jirayu3141/F9P_moving_base_pcb/ublox ZED-F9P (Full feature).kicad_pcb

## KiCad design ublox ZED-F9P (Full feature).kicad_pcb (2020-10-12)

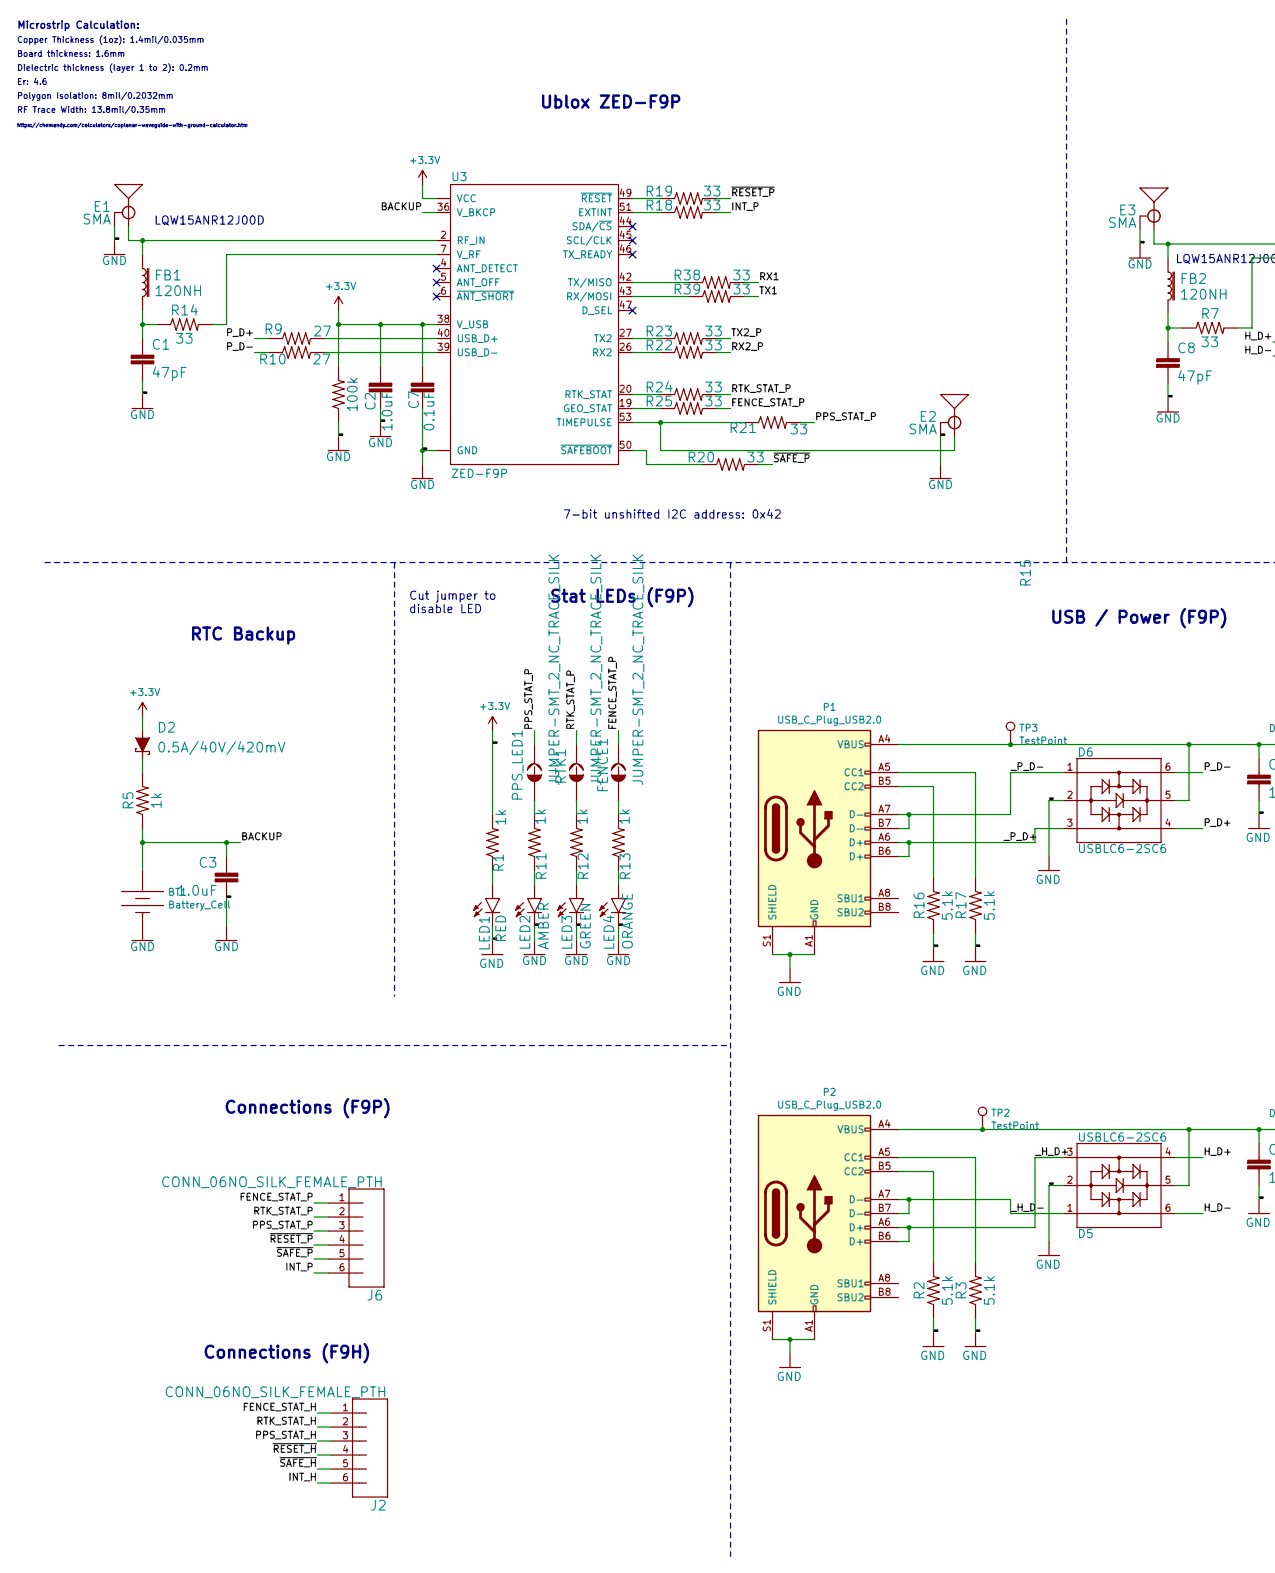
[picture p1: schematic ublox ZED-F9P (Full feature).sch, GNSS Module (Moving-Base RTK), part in row 1, column 1]

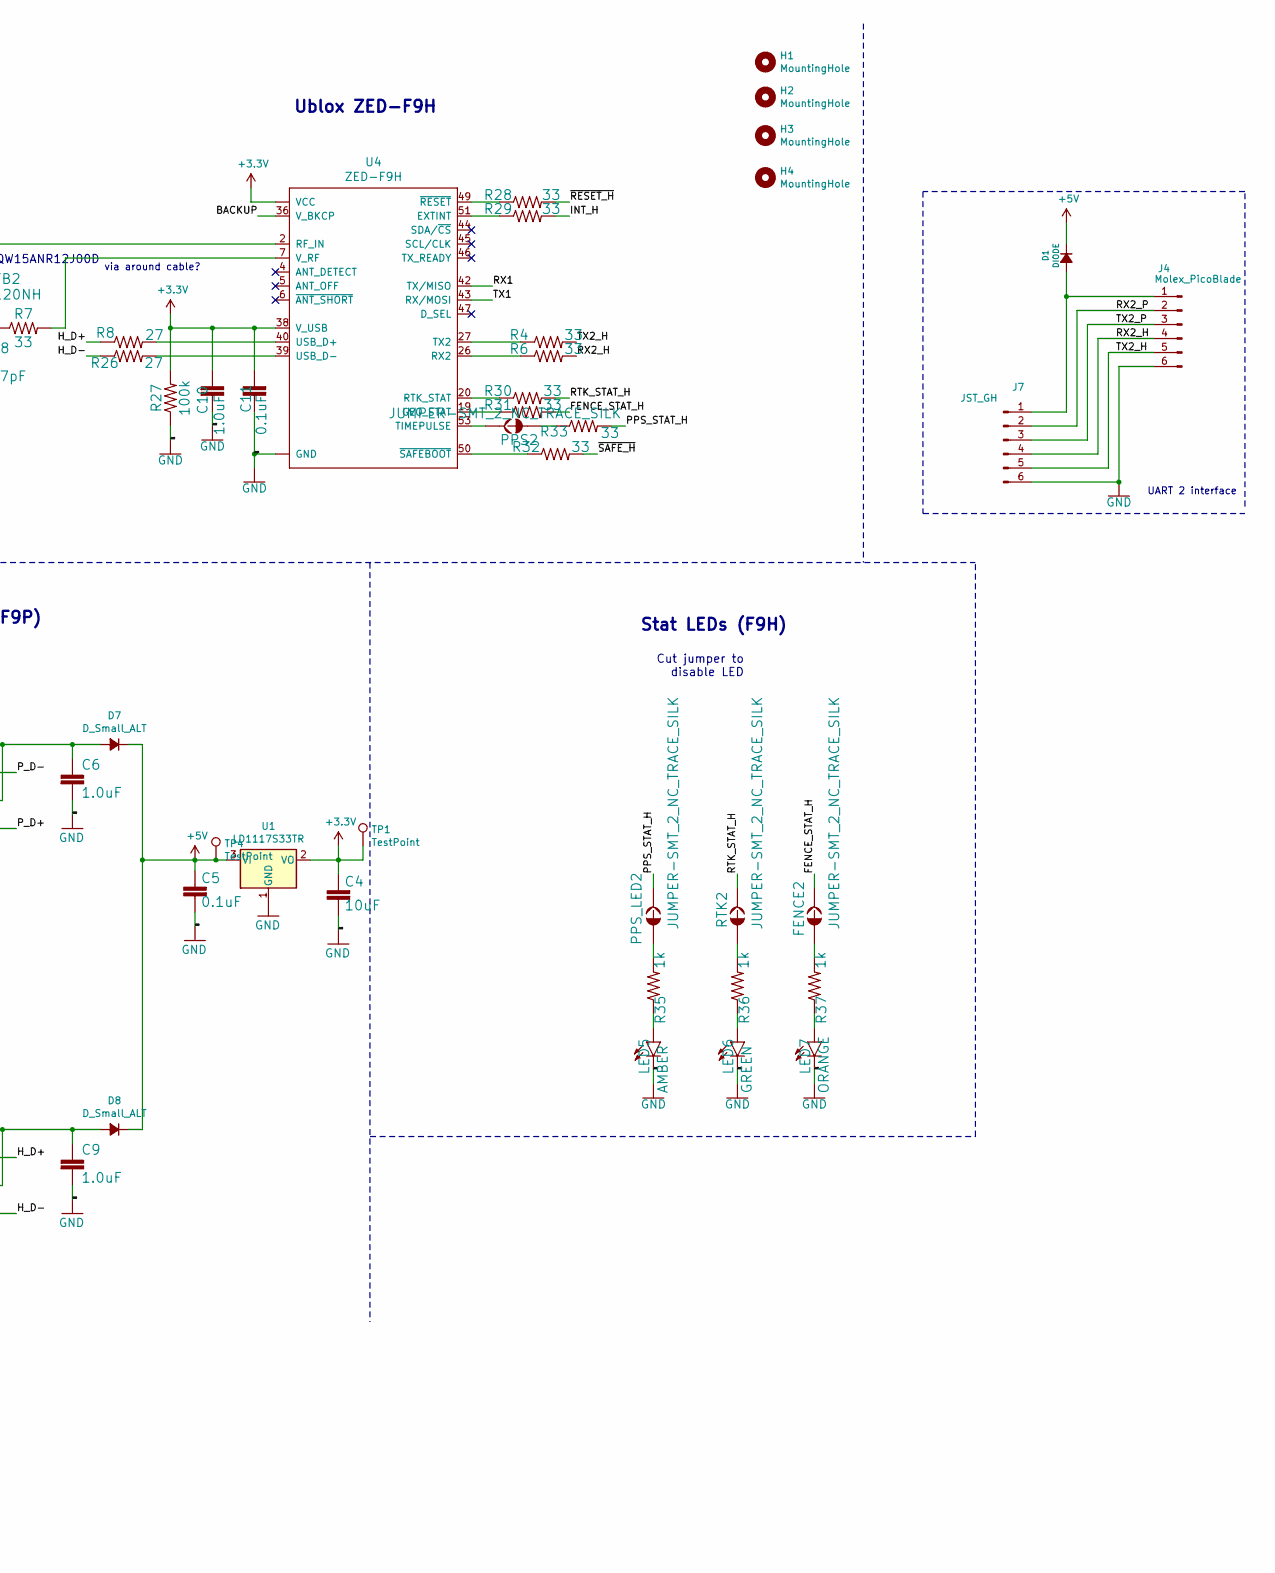
[picture p2: schematic ublox ZED-F9P (Full feature).sch, GNSS Module (Moving-Base RTK), part in row 1, column 2]

Parts:
BT1: Battery_Cell; ML414H_IV01E; partno ML414H IV01E
C1, C8: 47pF; 0402; partno 04023A470KAT2A
C2, C3, C6, C9, C10: 1.0uF; C_0603_1608Metric_Pad1.05x0.95mm_HandSolder; partno 0603YC105MAT2A
C4: 10uF; C_0603_1608Metric_Pad1.05x0.95mm_HandSolder; partno GRM188R61A106KE69D
C5, C7, C11: 0.1uF; C_0603_1608Metric_Pad1.05x0.95mm_HandSolder; partno MCCA000179
D1: DIODE; SOD-80; partno LS4150GS08
D2: 0.5A/40V/420mV; SOD-323; partno B0520WS-7-F
D5, D6: USBLC6-2SC6; SOT-23-6; partno USBLC6-2SC6
D7, D8: D_Small_ALT; SOD-80; partno LS4150GS08
E1, E2, E3: SMA; SMA-EDGE; partno CON-SMA-EDGE-S
FB1, FB2: 120NH; 0402_MURATA; partno BLM15AG100SN1D
FENCE1, FENCE2: JUMPER-SMT_2_NC_TRACE_SILK; SMT-JUMPER_2_NC_TRACE_SILK
H1, H2, H3, H4: MountingHole; MountingHole_3.2mm_M3
J2, J6: CONN_06NO_SILK_FEMALE_PTH; 1X06_NO_SILK
J4: Molex_PicoBlade; Molex_PicoBlade_53261-0671_1x06-1MP_P1.25mm_Horizontal; partno 532610671
J7: JST_GH; JST_GH_SM06B-GHS-TB_1x06-1MP_P1.25mm_Horizontal; partno SM06B-GHS-TB(LF)(SN)
LED1: RED; LED-0603; partno HSMH-C191
LED2, LED5: AMBER; LED-0603; partno HSMA-C191
LED3, LED6: GREEN; LED-0603; partno HSMG-C191
LED4, LED7: ORANGE; LED-0603; partno HSMD-C191
P1, P2: USB_C_Plug_USB2.0; USB_C_Receptacle_JAE_DX07S016JA1; partno DX07S016JA1R1500
PPS2: JUMPER-SMT_2_NC_TRACE_SILK; SMT-JUMPER_2_NC_TRACE_SILK
PPS_LED1, PPS_LED2: JUMPER-SMT_2_NC_TRACE_SILK; SMT-JUMPER_2_NC_TRACE_SILK
R1, R5, R11, R12, R13, R35, R36, R37: 1k; R_0603_1608Metric_Pad1.05x0.95mm_HandSolder; partno ERJ-3EKF1001V
R2, R3, R16, R17: 5.1k; R_0603_1608Metric_Pad1.05x0.95mm_HandSolder; partno ERJ-3EKF5101V
R4, R6, R7, R14, R18, R19, R20, R21, R22, R23, R24, R25, R28, R29, R30, R31, R32, R33, R38, R39: 33; R_0603_1608Metric_Pad1.05x0.95mm_HandSolder; partno ERJ-3EKF27R0V
R8, R9, R10, R26: 27; R_0603_1608Metric_Pad1.05x0.95mm_HandSolder; partno ERJ-3EKF27R0V
R15, R27: 100k; R_0603_1608Metric_Pad1.05x0.95mm_HandSolder; partno ERJ-3EKF1003V
RTK1, RTK2: JUMPER-SMT_2_NC_TRACE_SILK; SMT-JUMPER_2_NC_TRACE_SILK
TP1, TP2, TP3, TP4: TestPoint; TestPoint_Pad_D1.0mm
U1: LD1117S33TR; SOT-223; partno LD1117S33TR
U3: ZED-F9P; partno ZED-F9P-01B
U4: ZED-F9H; ZED-F9P

Connections:
+3V3: C2.1, C4.2, C7.2, C10.1, C11.2, D2.A, R1.2, R15.2, R27.2, TP1.1, U1.2 (VO), U3.33 (VCC), U3.34 (VCC), U3.38 (V_USB), U4.33 (VCC), U4.34 (VCC), U4.38 (V_USB); also elsewhere on the board
+5V: C5.2, D1.1 (K), D7.1 (K), D8.1 (K), TP4.1, U1.3 (VI); also elsewhere on the board
/BACKUP: BT1.+, C3.1, R5.1, U3.36 (V_BKCP), U4.36 (V_BKCP)
/FENCE_STAT_H: FENCE2.2, J2.1, R31.2
/FENCE_STAT_P: FENCE1.2, J6.1, R25.2
/H_D+: D5.4, R8.1
/H_D-: D5.6, R26.1
/INT_H: J2.6, R29.2
/INT_P: J6.6, R18.2
/PPS_STAT_H: J2.3, PPS_LED2.2, R33.2
/PPS_STAT_P: J6.3, PPS_LED1.2, R21.2
/P_D+: D6.4, R9.1
/P_D-: D6.6, R10.1
/RTK_STAT_H: J2.2, R30.2, RTK2.2
/RTK_STAT_P: J6.2, R24.2, RTK1.2
/RX1: R38.2, U4.42 (TX/MISO)
/RX2_H: J4.4, J7.4, R6.2
/RX2_P: J4.2, J7.2, R22.2
/TX1: R39.2, U4.43 (RX/MOSI)
/TX2_H: J4.5, J7.5, R4.2
/TX2_P: J4.3, J7.3, R23.2
/_H_D+: D5.3, P2.A6 (D+), P2.B6 (D+)
/_H_D-: D5.1, P2.A7 (D-), P2.B7 (D-)
/_P_D+: D6.3, P1.A6 (D+), P1.B6 (D+)
/_P_D-: D6.1, P1.A7 (D-), P1.B7 (D-)
/~RESET_H: J2.4, R28.2
/~RESET_P: J6.4, R19.2
/~SAFE_H: J2.5, R32.2
/~SAFE_P: J6.5, R20.2
GND: BT1.-, C1.2, C2.2, C3.2, C4.1, C5.1, C6.2, C7.1, C8.2, C9.2, C10.2, C11.1, D5.2, D6.2, E1.GND@0 (GND), E1.GND@1 (GND), E1.GND@2 (GND), E1.GND@3 (GND), E2.GND@0 (GND), E2.GND@1 (GND), E2.GND@2 (GND), E2.GND@3 (GND), E3.GND@0 (GND), E3.GND@1 (GND), E3.GND@2 (GND), E3.GND@3 (GND), J4.6, J7.6, LED1.C, LED2.C, LED3.C, LED4.C, LED5.C, LED6.C, LED7.C, P1.A1 (GND), P1.A12 (GND), P1.B1 (GND), P1.B12 (GND), P1.S1 (SHIELD), P2.A1 (GND), P2.A12 (GND), P2.B1 (GND), P2.B12 (GND), P2.S1 (SHIELD), R2.1, R3.1, R15.1, R16.1, R17.1, R27.1, U1.1 (GND), U3.1 (GND), U3.3 (GND), U3.12 (GND), U3.14 (GND), U3.32 (GND), U3.37 (GND), U3.41 (GND), U3.48 (GND), U3.55 (GND), U3.56 (GND), U3.57 (GND), U3.58 (GND), U3.59 (GND), U3.60 (GND), U3.61 (GND), U3.62 (GND), U3.63 (GND), U3.64 (GND), U3.65 (GND), U3.66 (GND), U3.67 (GND), U3.68 (GND), U3.69 (GND), U3.70 (GND), U3.71 (GND), U3.72 (GND), U3.73 (GND), U3.74 (GND), U3.75 (GND), U3.76 (GND), U3.77 (GND), U3.78 (GND), U3.79 (GND), U3.80 (GND), U3.81 (GND), U3.82 (GND), U3.83 (GND), U3.84 (GND), U3.85 (GND), U3.86 (GND), U3.87 (GND), U3.88 (GND), U3.89 (GND), U3.90 (GND), U3.91 (GND), U3.92 (GND), U3.93 (GND), U3.94 (GND), U3.95 (GND), U3.96 (GND), U3.97 (GND), U3.98 (GND), U3.99 (GND), U3.100 (GND), U3.101 (GND), U3.102 (GND), U4.1 (GND), U4.3 (GND), U4.12 (GND), U4.14 (GND), U4.32 (GND), U4.37 (GND), U4.41 (GND), U4.48 (GND), U4.55 (GND), U4.56 (GND), U4.57 (GND), U4.58 (GND), U4.59 (GND), U4.60 (GND), U4.61 (GND), U4.62 (GND), U4.63 (GND), U4.64 (GND), U4.65 (GND), U4.66 (GND), U4.67 (GND), U4.68 (GND), U4.69 (GND), U4.70 (GND), U4.71 (GND), U4.72 (GND), U4.73 (GND), U4.74 (GND), U4.75 (GND), U4.76 (GND), U4.77 (GND), U4.78 (GND), U4.79 (GND), U4.80 (GND), U4.81 (GND), U4.82 (GND), U4.83 (GND), U4.84 (GND), U4.85 (GND), U4.86 (GND), U4.87 (GND), U4.88 (GND), U4.89 (GND), U4.90 (GND), U4.91 (GND), U4.92 (GND), U4.93 (GND), U4.94 (GND), U4.95 (GND), U4.96 (GND), U4.97 (GND), U4.98 (GND), U4.99 (GND), U4.100 (GND), U4.101 (GND), U4.102 (GND)
unnamed: C1.1, FB1.P2 (2), R14.1
unnamed 31: C6.1, D6.5, D7.2 (A), P1.A4 (VBUS), P1.A9 (VBUS), P1.B4 (VBUS), P1.B9 (VBUS), TP3.1; also elsewhere on the board
unnamed: C8.1, FB2.P2 (2), R7.1
unnamed 33: C9.1, D5.5, D8.2 (A), P2.A4 (VBUS), P2.A9 (VBUS), P2.B4 (VBUS), P2.B9 (VBUS), TP2.1; also elsewhere on the board
unnamed: D1.2 (A), J4.1, J7.1
unnamed: D2.C, R5.2
unnamed: E1.SIG (SIGNAL), FB1.P1 (1), U3.2 (RF_IN)
unnamed: E2.SIG (SIGNAL), R21.1, U3.53 (TIMEPULSE)
unnamed: E3.SIG (SIGNAL), FB2.P1 (1), U4.2 (RF_IN)
unnamed: FENCE1.1, R13.2
unnamed: FENCE2.1, R37.2
unnamed: LED1.A, R1.1
unnamed: LED2.A, R11.1
unnamed: LED3.A, R12.1
unnamed: LED4.A, R13.1
unnamed: LED5.A, R35.1
unnamed: LED6.A, R36.1
unnamed: LED7.A, R37.1
unnamed: P1.A5 (CC1), R17.2
unnamed: P1.B5 (CC2), R16.2
unnamed: P2.A5 (CC1), R3.2
unnamed: P2.B5 (CC2), R2.2
unnamed: PPS2.1, R33.1
unnamed: PPS2.2, U4.53 (TIMEPULSE)
unnamed: PPS_LED1.1, R11.2
unnamed: PPS_LED2.1, R35.2
unnamed: R4.1, U4.27 (TX2)
unnamed: R6.1, U4.26 (RX2)
unnamed: R7.2, U4.7 (V_RF)
unnamed: R8.2, U4.40 (USB_D+)
unnamed: R9.2, U3.40 (USB_D+)
unnamed: R10.2, U3.39 (USB_D-)
unnamed: R12.2, RTK1.1
unnamed: R14.2, U3.7 (V_RF)
unnamed: R18.1, U3.51 (EXTINT)
unnamed: R19.1, U3.49 (~RESET~)
unnamed: R20.1, U3.50 (~SAFEBOOT~)
unnamed: R22.1, U3.26 (RX2)
unnamed: R23.1, U3.27 (TX2)
unnamed: R24.1, U3.20 (RTK_STAT)
unnamed: R25.1, U3.19 (GEO_STAT)
unnamed: R26.2, U4.39 (USB_D-)
unnamed: R28.1, U4.49 (~RESET~)
unnamed: R29.1, U4.51 (EXTINT)
unnamed: R30.1, U4.20 (RTK_STAT)
unnamed: R31.1, U4.19 (GEO_STAT)
unnamed: R32.1, U4.50 (~SAFEBOOT~)
unnamed: R36.2, RTK2.1
unnamed: R38.1, U3.42 (TX/MISO)
unnamed: R39.1, U3.43 (RX/MOSI)

Notes on the sheet:
7-bit unshifted I2C address: 0x42
Ublox ZED-F9P
RTC Backup
Cut jumper to disable LED
LQW15ANR12J00D
Board thickness: 1.6mm
Er: 4.6
Copper Thickness (1oz): 1.4mil/0.035mm
RF Trace Width: 13.8mil/0.35mm
Polygon Isolation: 8mil/0.2032mm
Dielectric thickness (layer 1 to 2): 0.2mm
https://chemandy.com/calculators/coplanar-waveguide-with-ground-calculator.htm
Microstrip Calculation:
Connections (F9P)
USB / Power (F9P)
Ublox ZED-F9H
Stat LEDs (F9P)
Stat LEDs (F9H)
Connections (F9H)
via around cable?
UART 2 interface

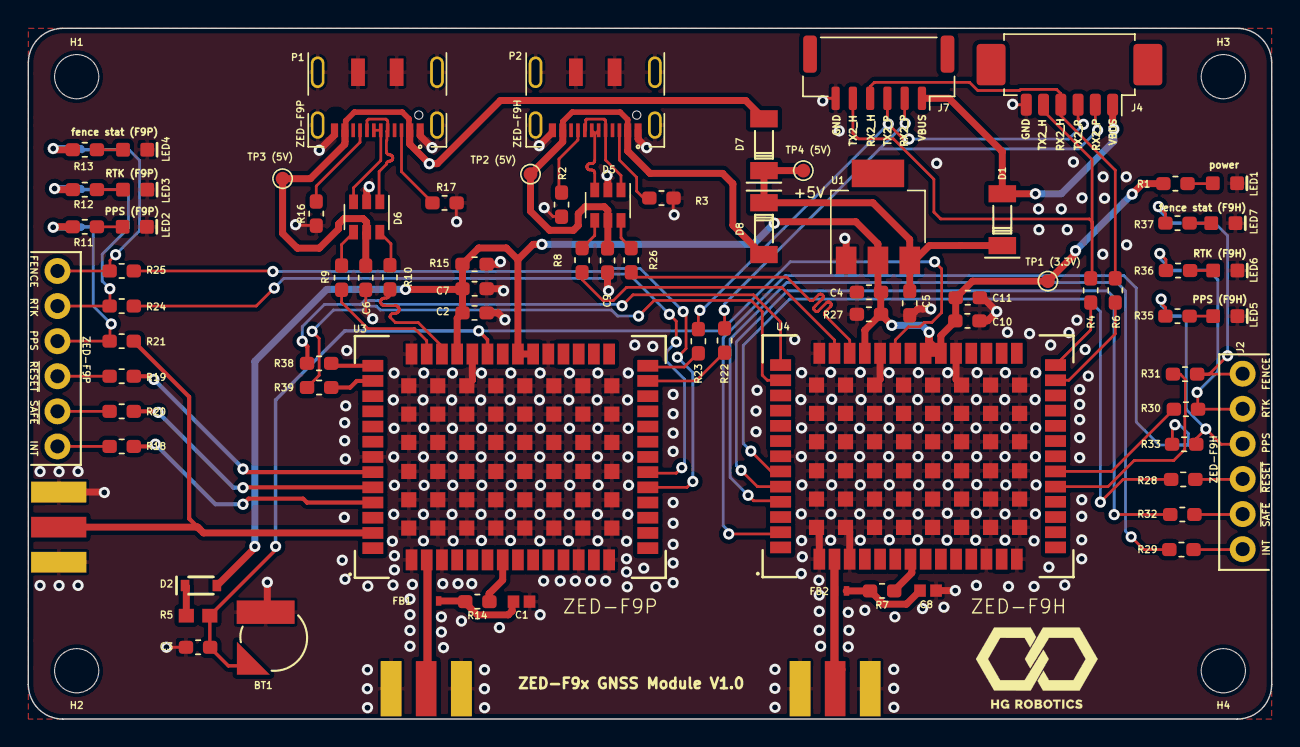
[picture p3: board ublox ZED-F9P (Full feature).kicad_pcb from above]

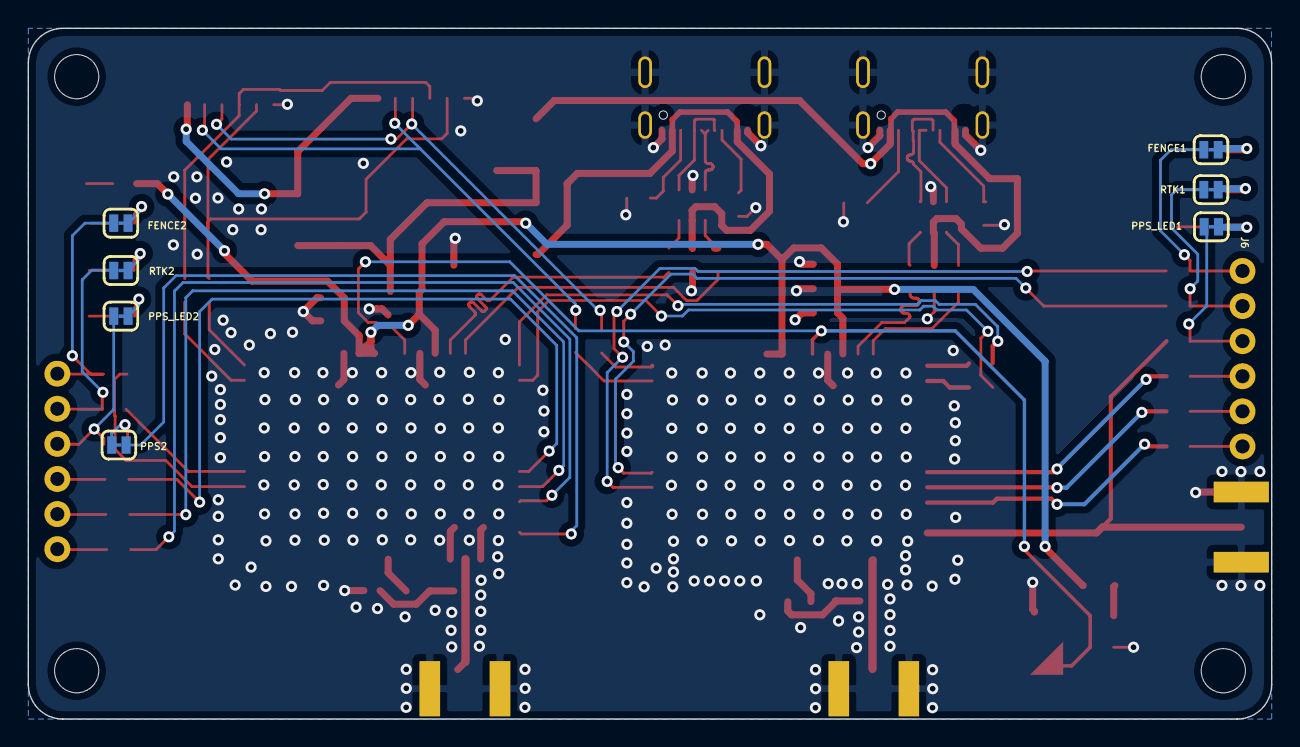
[picture p4: board ublox ZED-F9P (Full feature).kicad_pcb from below]

Board: 4 copper layers, 90.0 x 50.0 mm, 92 parts (8 on the bottom side), 80 nets.

Other parts of the board:
TP1 (3.3V), TP2 (5V), TP3 (5V), TP4 (5V): TestPoint; TestPoint_Pad_D1.0mm

Their connections:
+3V3: TP1 (3.3V).1; also elsewhere on the board
+5V: TP4 (5V).1; also elsewhere on the board
unnamed 31: TP3 (5V).1; also elsewhere on the board
unnamed 33: TP2 (5V).1; also elsewhere on the board
