jirayu3141/F9P_moving_base_pcb/F9R.kicad_pcb

## KiCad design F9R.kicad_pcb (2020-10-07)

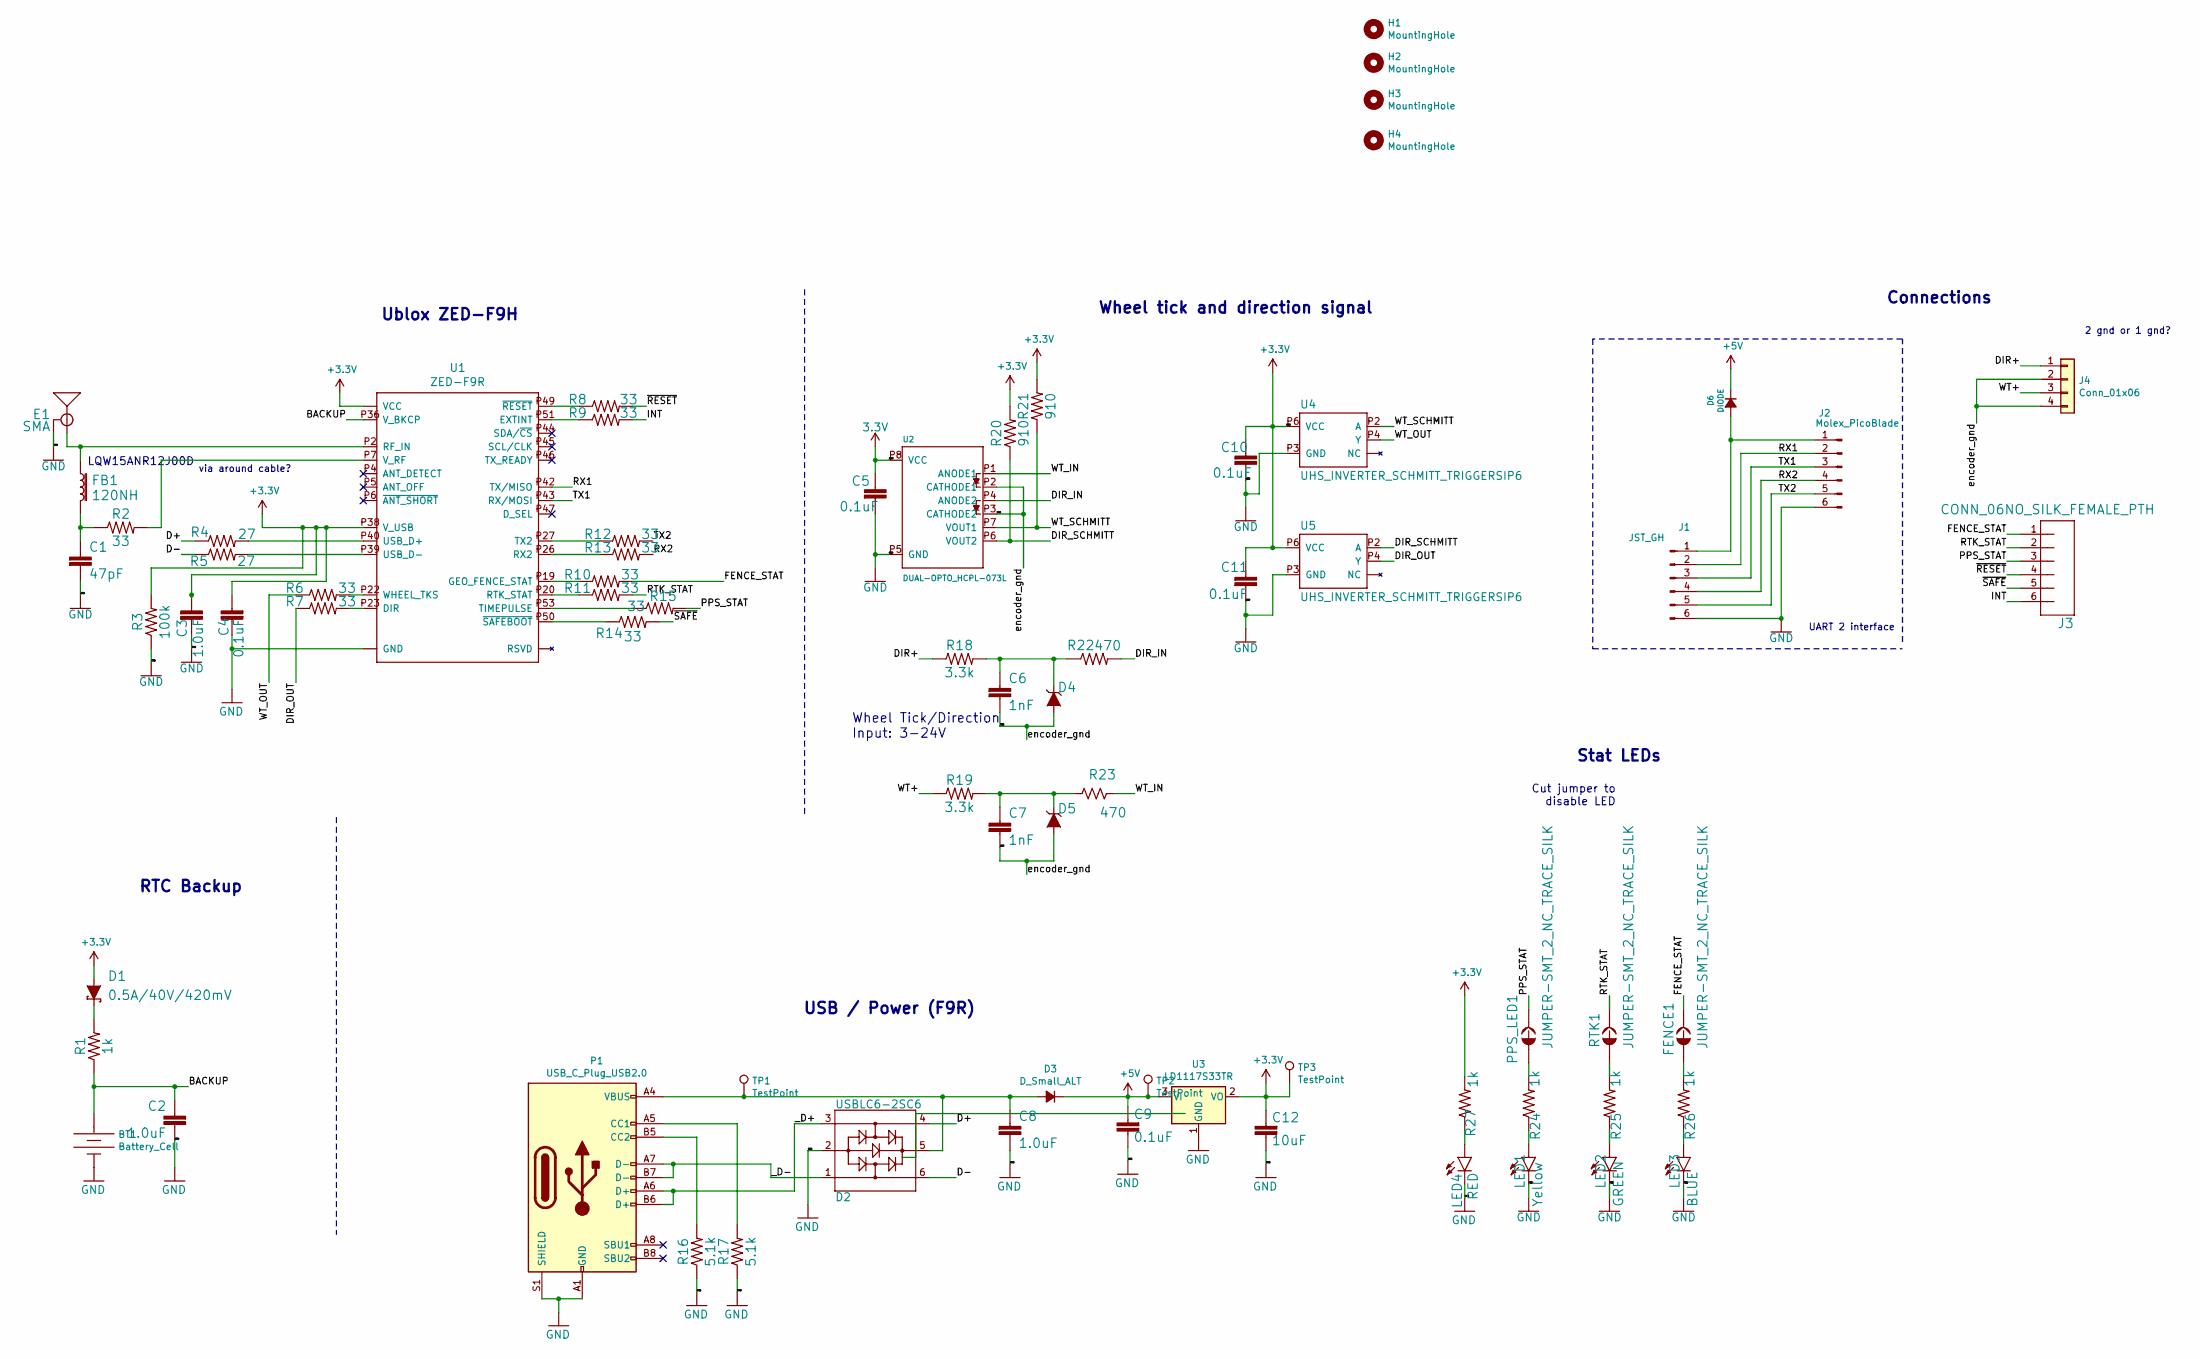
[picture p5: schematic F9R.sch, GNSS Module (Moving-Base RTK) ZED F9R]

Parts:
BT1: Battery_Cell; ML414H_IV01E; partno ML414H IV01E
C1: 47pF; 0402; partno 04023A470KAT2A
C2, C3, C8: 1.0uF; C_0603_1608Metric_Pad1.05x0.95mm_HandSolder; partno 0603YC105KAT2A
C4, C9: 0.1uF; C_0603_1608Metric_Pad1.05x0.95mm_HandSolder; partno 0603YC104KAT2A
C5, C10, C11: 0.1uF; C_0603_1608Metric_Pad1.05x0.95mm_HandSolder
C6, C7: 1nF; C_0603_1608Metric_Pad1.05x0.95mm_HandSolder
C12: 10uF; C_0603_1608Metric_Pad1.05x0.95mm_HandSolder; partno 0603ZD106KAT2A
D1: 0.5A/40V/420mV; SOD-323; partno B0520WS-7-F
D2: USBLC6-2SC6; SOT-23-6; partno USBLC6-2SC6
D3: D_Small_ALT; SOD-80; partno LS4150GS08
D4, D5: 15V; SOT23-3
D6: DIODE; SOD-80; partno LS4150GS08
E1: SMA; SMA-EDGE; partno CON-SMA-EDGE-S
FB1: 120NH; 0402_MURATA; partno BLM15AG100SN1D
FENCE1: JUMPER-SMT_2_NC_TRACE_SILK; SMT-JUMPER_2_NC_TRACE_SILK
H1, H2, H3, H4: MountingHole; MountingHole_3.2mm_M3
J1: JST_GH; JST_GH_SM06B-GHS-TB_1x06-1MP_P1.25mm_Horizontal; partno SM06B-GHS-TB(LF)(SN)
J2: Molex_PicoBlade; Molex_PicoBlade_53261-0671_1x06-1MP_P1.25mm_Horizontal; partno 0532610671
J3: CONN_06NO_SILK_FEMALE_PTH; 1X06_NO_SILK
J4: Conn_01x06; Molex_CLIK-Mate_502443-0470_1x04-1MP_P2.00mm_Vertical
LED1: Yellow; LED-0603; partno LY Q396-P1Q2-36
LED2: GREEN; LED-0603; partno HSMG-C120
LED3: BLUE; LED-0603; partno 150060BS55040
LED4: RED; LED-0603; partno HSMH-C191
P1: USB_C_Plug_USB2.0; USB_C_Receptacle_JAE_DX07S016JA1
PPS_LED1: JUMPER-SMT_2_NC_TRACE_SILK; SMT-JUMPER_2_NC_TRACE_SILK
R1: 1k; 0603; partno ERJ-3EKF1001V
R2, R6, R7, R8, R9, R10, R11, R12, R13, R14, R15: 33; R_0603_1608Metric_Pad1.05x0.95mm_HandSolder; partno ERJ-3EKF27R0V
R3: 100k; R_0603_1608Metric_Pad1.05x0.95mm_HandSolder; partno ERJ-3EKF1003V
R4, R5: 27; R_0603_1608Metric_Pad1.05x0.95mm_HandSolder; partno ERJ-3EKF27R0V
R16, R17: 5.1k; R_0603_1608Metric_Pad1.05x0.95mm_HandSolder; partno ERJ-3EKF5101V
R18, R19: 3.3k; R_0603_1608Metric_Pad1.05x0.95mm_HandSolder
R20, R21: 910; R_0603_1608Metric_Pad1.05x0.95mm_HandSolder
R22, R23: 470; R_0603_1608Metric_Pad1.05x0.95mm_HandSolder
R24, R25, R26, R27: 1k; R_0603_1608Metric_Pad1.05x0.95mm_HandSolder; partno ERJ-3EKF1001V
RTK1: JUMPER-SMT_2_NC_TRACE_SILK; SMT-JUMPER_2_NC_TRACE_SILK
TP1, TP2, TP3: TestPoint; TestPoint_Pad_D1.0mm
U1: ZED-F9R; UBLOX_ZED_F9R
U2: DUAL-OPTO_HCPL-073L; SOP_8-PIN
U3: LD1117S33TR; SOT-223; partno LD1117S33TR
U4, U5: UHS_INVERTER_SCHMITT_TRIGGERSIP6; SIP6

Connections:
+3V3: C3.1, C4.2, C5.1, C10.1, C11.1, C12.2, D1.A, R3.2, R20.2, R21.2, R27.2, TP3.1, U1.P33 (VCC), U1.P34 (VCC), U1.P38 (V_USB), U2.P8 (VCC), U3.2 (VO), U4.P6 (VCC), U5.P6 (VCC)
+5V: C9.2, D3.1 (K), D6.1 (K), TP2.1, U3.3 (VI)
/BACKUP: BT1.+, C2.1, R1.1, U1.P36 (V_BKCP)
/D+: D2.4, R4.1
/D-: D2.6, R5.1
/DIR+: J4.1, R18.1
/DIR_IN: R22.2, U2.P4 (ANODE2)
/DIR_OUT: R7.1, U5.P4 (Y)
/DIR_SCHMITT: R20.1, U2.P6 (VOUT2), U5.P2 (A)
/FENCE_STAT: FENCE1.2, J3.1, R10.2
/INT: J3.6, R9.2
/PPS_STAT: J3.3, PPS_LED1.2, R15.2
/RTK_STAT: J3.2, R11.2, RTK1.2
/RX1: J1.2, J2.2, U1.P42 (TX/MISO)
/RX2: J1.4, J2.4, R13.2
/TX1: J1.3, J2.3, U1.P43 (RX/MOSI)
/TX2: J1.5, J2.5, R12.2
/WT+: J4.3, R19.1
/WT_IN: R23.1, U2.P1 (ANODE1)
/WT_OUT: R6.1, U4.P4 (Y)
/WT_SCHMITT: R21.1, U2.P7 (VOUT1), U4.P2 (A)
/_D+: D2.3, P1.A6 (D+), P1.B6 (D+)
/_D-: D2.1, P1.A7 (D-), P1.B7 (D-)
/~RESET: J3.4, R8.2
/~SAFE: J3.5, R14.2
GND: BT1.-, C1.2, C2.2, C3.2, C4.1, C5.2, C6.2, C7.2, C8.2, C9.1, C10.2, C11.2, C12.1, D2.2, D4.1 (A), D5.1 (A), E1.GND@0 (GND), E1.GND@1 (GND), E1.GND@2 (GND), E1.GND@3 (GND), J1.6, J2.6, J4.2, J4.4, LED1.C, LED2.C, LED3.C, LED4.C, P1.A1 (GND), P1.A12 (GND), P1.B1 (GND), P1.B12 (GND), P1.S1 (SHIELD), R3.1, R16.1, R17.1, U1.G1 (GND), U1.G2 (GND), U1.G3 (GND), U1.G4 (GND), U1.G5 (GND), U1.G6 (GND), U1.G7 (GND), U1.G8 (GND), U1.G9 (GND), U1.G10 (GND), U1.G11 (GND), U1.G12 (GND), U1.G13 (GND), U1.G14 (GND), U1.G15 (GND), U1.G16 (GND), U1.G17 (GND), U1.G18 (GND), U1.G19 (GND), U1.G20 (GND), U1.G21 (GND), U1.G22 (GND), U1.G23 (GND), U1.G24 (GND), U1.G25 (GND), U1.G26 (GND), U1.G27 (GND), U1.G28 (GND), U1.G29 (GND), U1.G30 (GND), U1.G31 (GND), U1.G32 (GND), U1.G33 (GND), U1.G34 (GND), U1.G35 (GND), U1.G36 (GND), U1.G37 (GND), U1.G38 (GND), U1.G39 (GND), U1.G40 (GND), U1.G41 (GND), U1.G42 (GND), U1.G43 (GND), U1.G44 (GND), U1.G45 (GND), U1.G46 (GND), U1.G47 (GND), U1.G48 (GND), U1.P1 (GND), U1.P3 (GND), U1.P12 (GND), U1.P14 (GND), U1.P32 (GND), U1.P37 (GND), U1.P41 (GND), U1.P48 (GND), U2.P2 (CATHODE1), U2.P3 (CATHODE2), U2.P5 (GND), U3.1 (GND), U4.P3 (GND), U5.P3 (GND)
unnamed: C1.1, FB1.P2 (2), R2.1
unnamed: C6.1, D4.3 (C), R18.2, R22.1
unnamed: C7.1, D5.3 (C), R19.2, R23.2
unnamed: C8.1, D2.5, D3.2 (A), P1.A4 (VBUS), P1.A9 (VBUS), P1.B4 (VBUS), P1.B9 (VBUS), TP1.1
unnamed: D1.C, R1.2
unnamed: D6.2 (A), J1.1, J2.1
unnamed: E1.SIG (SIGNAL), FB1.P1 (1), U1.P2 (RF_IN)
unnamed: FENCE1.1, R26.2
unnamed: LED1.A, R24.1
unnamed: LED2.A, R25.1
unnamed: LED3.A, R26.1
unnamed: LED4.A, R27.1
unnamed: P1.A5 (CC1), R17.2
unnamed: P1.B5 (CC2), R16.2
unnamed: PPS_LED1.1, R24.2
unnamed: R2.2, U1.P7 (V_RF)
unnamed: R4.2, U1.P40 (USB_D+)
unnamed: R5.2, U1.P39 (USB_D-)
unnamed: R6.2, U1.P22 (WHEEL_TKS)
unnamed: R7.2, U1.P23 (DIR)
unnamed: R8.1, U1.P49 (~RESET~)
unnamed: R9.1, U1.P51 (EXTINT)
unnamed: R10.1, U1.P19 (GEO_FENCE_STAT)
unnamed: R11.1, U1.P20 (RTK_STAT)
unnamed: R12.1, U1.P27 (TX2)
unnamed: R13.1, U1.P26 (RX2)
unnamed: R14.1, U1.P50 (~SAFEBOOT~)
unnamed: R15.1, U1.P53 (TIMEPULSE)
unnamed: R25.2, RTK1.1

Notes on the sheet:
RTC Backup
USB / Power (F9R)
Ublox ZED-F9H
Cut jumper to disable LED
LQW15ANR12J00D
Stat LEDs
via around cable?
UART 2 interface
Wheel Tick/Direction Input: 3-24V
Wheel tick and direction signal
2 gnd or 1 gnd?
Connections

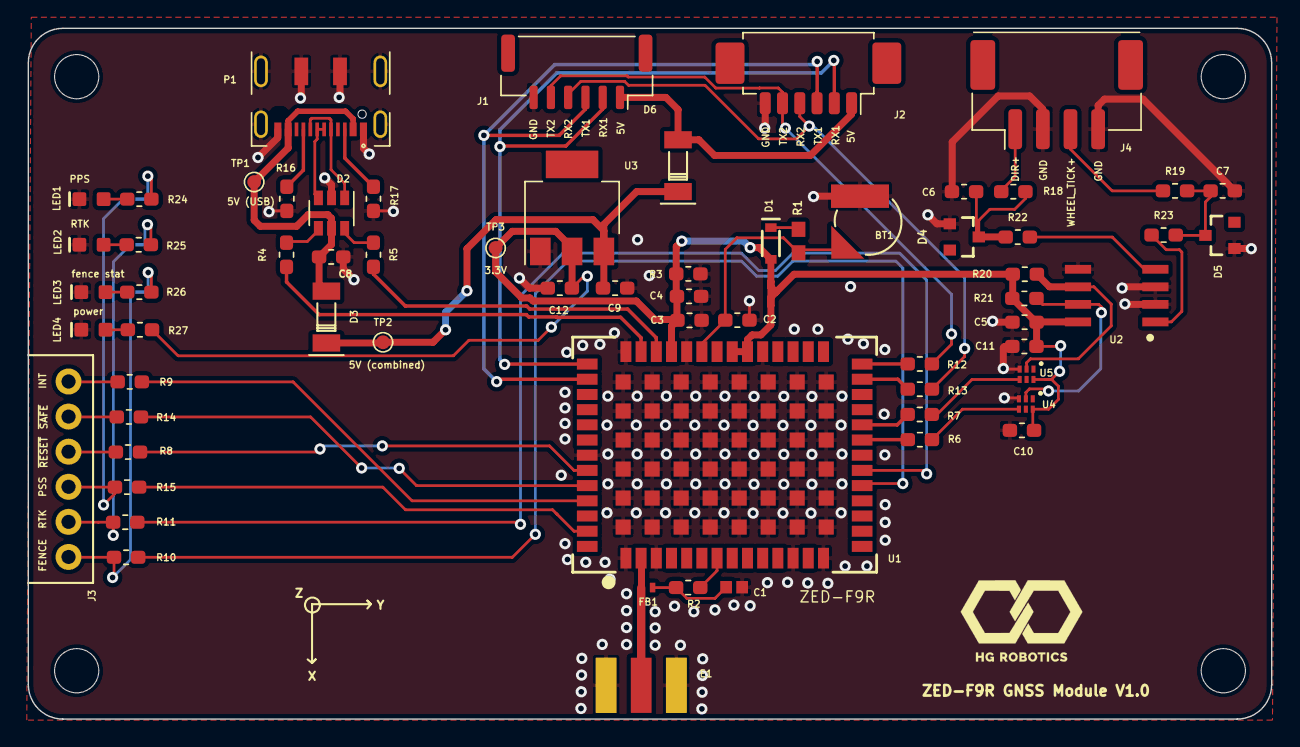
[picture p6: board F9R.kicad_pcb from above]

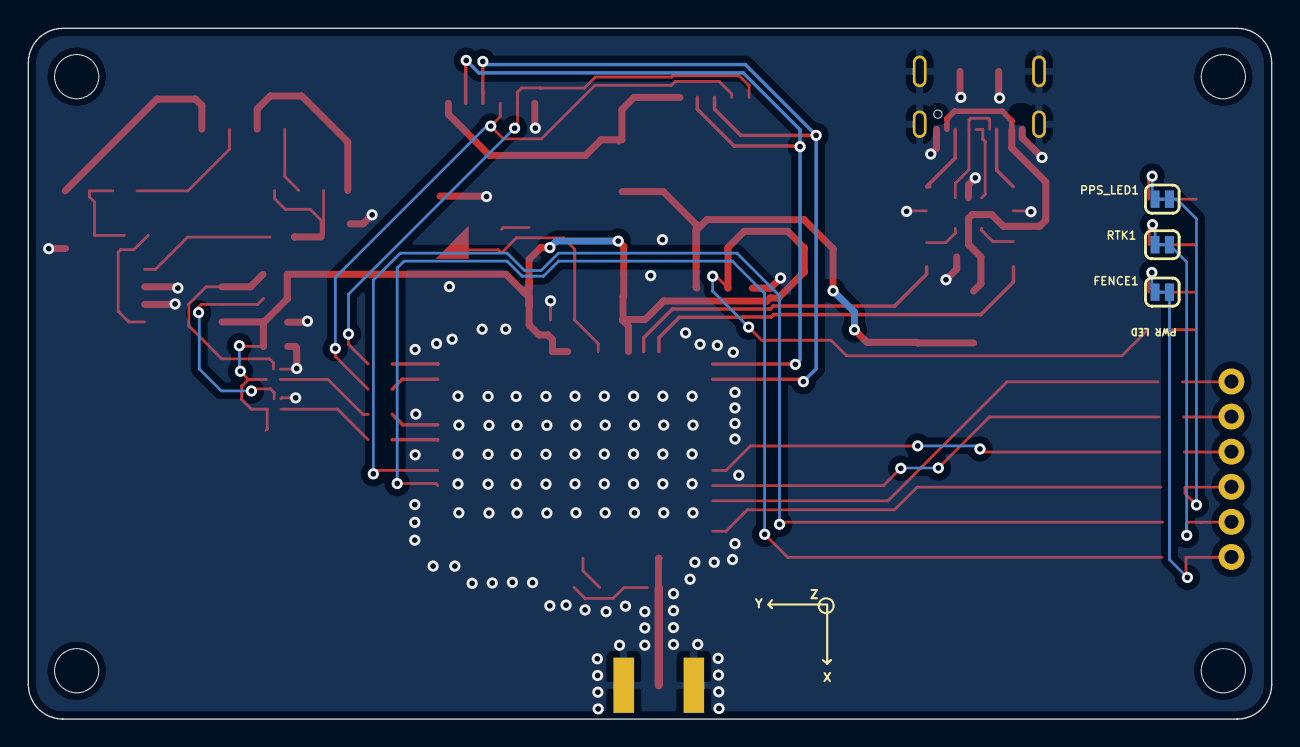
[picture p7: board F9R.kicad_pcb from below]

Board: 4 copper layers, 90.0 x 50.0 mm, 72 parts (3 on the bottom side), 55 nets.
