jirayu3141/F9P_moving_base_pcb/(commit log)

2020-09-23 name changed
    [ublox ZED-F9P (Full feature).kicad_pcb, ublox ZED-F9P (Full feature).sch]
2020-09-23 Try pushing this repo
    [ublox ZED-F9P (Full feature).sch]
2020-09-23 Update partno
    [ublox ZED-F9P (Full feature).sch]
2020-09-23 part no updated
    [ublox ZED-F9P (Full feature).sch]
2020-09-24 removed unescessary resistors
    [ublox ZED-F9P (Full feature).sch]
2020-09-24 removed SMA time paulse from F9H
    [ublox ZED-F9P (Full feature).sch]
2020-09-26 changed usb c
    [ublox ZED-F9P (Full feature).kicad_pcb, ublox ZED-F9P (Full feature).sch]
2020-09-29 changed usb c differential pair
    [ublox ZED-F9P (Full feature).kicad_pcb, ublox ZED-F9P (Full feature).sch]
2020-10-01 finished routing
    [ublox ZED-F9P (Full feature) copy.kicad_pcb, ublox ZED-F9P (Full feature).sch]
2020-10-01 updated new consistent footprint and silkscreen
    [ublox ZED-F9P (Full feature).kicad_pcb, ublox ZED-F9P (Full feature).sch]
2020-10-01 updated silkscreen
    [ublox ZED-F9P (Full feature).kicad_pcb]
2020-10-01 added logo;
    [ublox ZED-F9P (Full feature).kicad_pcb]
2020-10-01 finished export
    [ublox ZED-F9P (Full feature)-B_Cu.gbr, ublox ZED-F9P (Full feature)-B_Mask.gbr, ublox ZED-F9P (Full feature)-B_Paste.gbr, ublox ZED-F9P (Full feature)-B_SilkS.gbr, ublox ZED-F9P (Full feature)-Edge_Cuts.gbr, ublox ZED-F9P (Full feature)-F_Cu.gbr, ublox ZED-F9P (Full feature)-F_Mask.gbr, ublox ZED-F9P (Full feature)-F_Paste.gbr]
2020-10-02 finished v1.1
    [ublox ZED-F9P (Full feature)-B_Cu.gbr, ublox ZED-F9P (Full feature)-B_Mask.gbr, ublox ZED-F9P (Full feature)-B_Paste.gbr, ublox ZED-F9P (Full feature)-B_SilkS.gbr, ublox ZED-F9P (Full feature)-Edge_Cuts.gbr, ublox ZED-F9P (Full feature)-F_Cu.gbr, ublox ZED-F9P (Full feature)-F_Mask.gbr, ublox ZED-F9P (Full feature)-F_Paste.gbr]
2020-10-02 genereated output
    [ublox ZED-F9P (Full feature)-B_Cu.gbr, ublox ZED-F9P (Full feature)-B_Mask.gbr, ublox ZED-F9P (Full feature)-B_Paste.gbr, ublox ZED-F9P (Full feature)-B_SilkS.gbr, ublox ZED-F9P (Full feature)-Edge_Cuts.gbr, ublox ZED-F9P (Full feature)-F_Cu.gbr, ublox ZED-F9P (Full feature)-F_Mask.gbr, ublox ZED-F9P (Full feature)-F_Paste.gbr]
2020-10-02 deleted unused files
    [ublox ZED-F9P (Full feature).kicad_pcb]
2020-10-06 routed f9r
    [F9R.kicad_pcb, F9R.sch, file5F77EE76.sch]
2020-10-06 rearrange silkscreen H1-H4,P1-P2,J4,J7 remove bottom silkscreen PWR LED resize all footprint references to height0.5,width0.5,thichness0.1 mm Add silkscreen label for pins of J2,J4,J6, J7
    [ublox ZED-F9P (Full feature)-B_Cu.gbr, ublox ZED-F9P (Full feature)-B_Mask.gbr, ublox ZED-F9P (Full feature)-B_Paste.gbr, ublox ZED-F9P (Full feature)-B_SilkS.gbr, ublox ZED-F9P (Full feature)-Edge_Cuts.gbr, ublox ZED-F9P (Full feature)-F_Cu.gbr, ublox ZED-F9P (Full feature)-F_Mask.gbr, ublox ZED-F9P (Full feature)-F_Paste.gbr]
2020-10-06 finished f9r
    [F9R.kicad_pcb, F9R.sch, file5F77EE76.sch]
2020-10-06 added logo
    [F9R.kicad_pcb]
2020-10-06 adjusted label
    [F9R.kicad_pcb]
2020-10-06 added direction to the back
    [F9R.kicad_pcb]
2020-10-06 edited silk screen
    [F9R.kicad_pcb]
2020-10-06 edited silk screen to 0.5, 0.5, 0.1 size
    [F9R.kicad_pcb]
2020-10-06 Add HGR logo
    [ublox ZED-F9P (Full feature)-B_Cu.gbr, ublox ZED-F9P (Full feature)-B_Mask.gbr, ublox ZED-F9P (Full feature)-B_Paste.gbr, ublox ZED-F9P (Full feature)-B_SilkS.gbr, ublox ZED-F9P (Full feature)-Edge_Cuts.gbr, ublox ZED-F9P (Full feature)-F_Cu.gbr, ublox ZED-F9P (Full feature)-F_Mask.gbr, ublox ZED-F9P (Full feature)-F_Paste.gbr]
2020-10-06 Add gerber.zip
2020-10-07 added silkscreen to testpoint
    [ublox ZED-F9P (Full feature).kicad_pcb]
2020-10-07 edited BOM
    [F9R.kicad_pcb, F9R.sch]
