jirayu3141/F9P_moving_base_pcb/(notices)

Notices in the files:
parts and their libraries:
https://creativecommons.org/licenses/by-sa/4.0
Released under the Creative Commons Attribution Share-Alike 4.0 License
